HighInBC/ZeroCool/README.md

# ZeroCool
Zero cool is a Raspberry Pi Zero based portable bitcoin wallet printer.

This project is not ready for public consumption at this point.

The name of the project is a reference to one of the best/worst hacker movies ever made **Hackers**(1995).
