HighInBC/ZeroCool/hardware/rev_b/README.md

Warning, this board revision has serious flaws including the barrel jack having the wrong polarity.
DO NOT USE
