HighInBC/ZeroCool/hardware/rev_g/rev_g.pdf

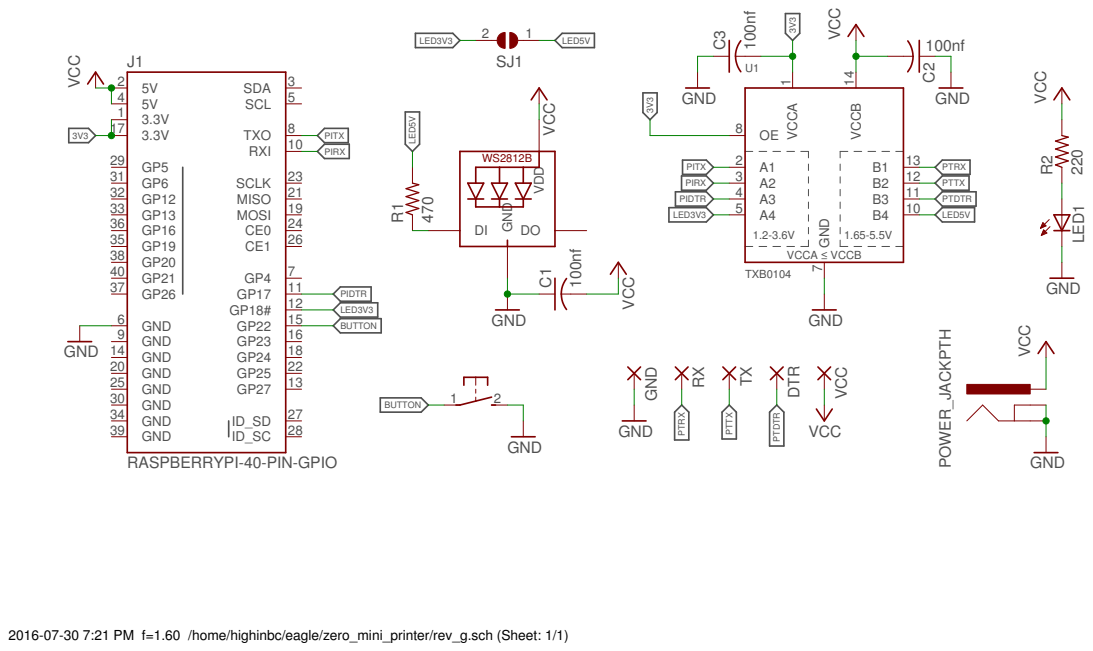
[picture p1: page 1]

2016-07-30 7:21 PM f=1.60 /home/highinbc/eagle/zero_mini_printer/rev_g.sch (Sheet: 1/1)
