HighInBC/ZeroCool/hardware/rev_b/rev_b.pdf

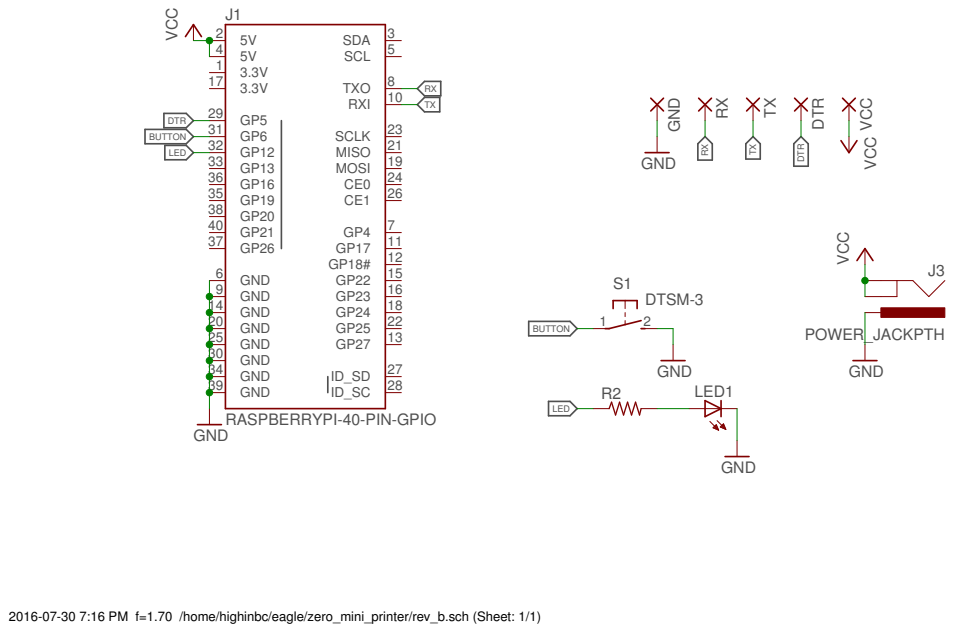
[picture p2: page 1]

2016-07-30 7:16 PM f=1.70 /home/highinbc/eagle/zero_mini_printer/rev_b.sch (Sheet: 1/1)
