HighInBC/ZeroCool/hardware/rev_g/rev_g.brd

## EAGLE design hardware/rev_g/rev_g.brd (2016-07-31)

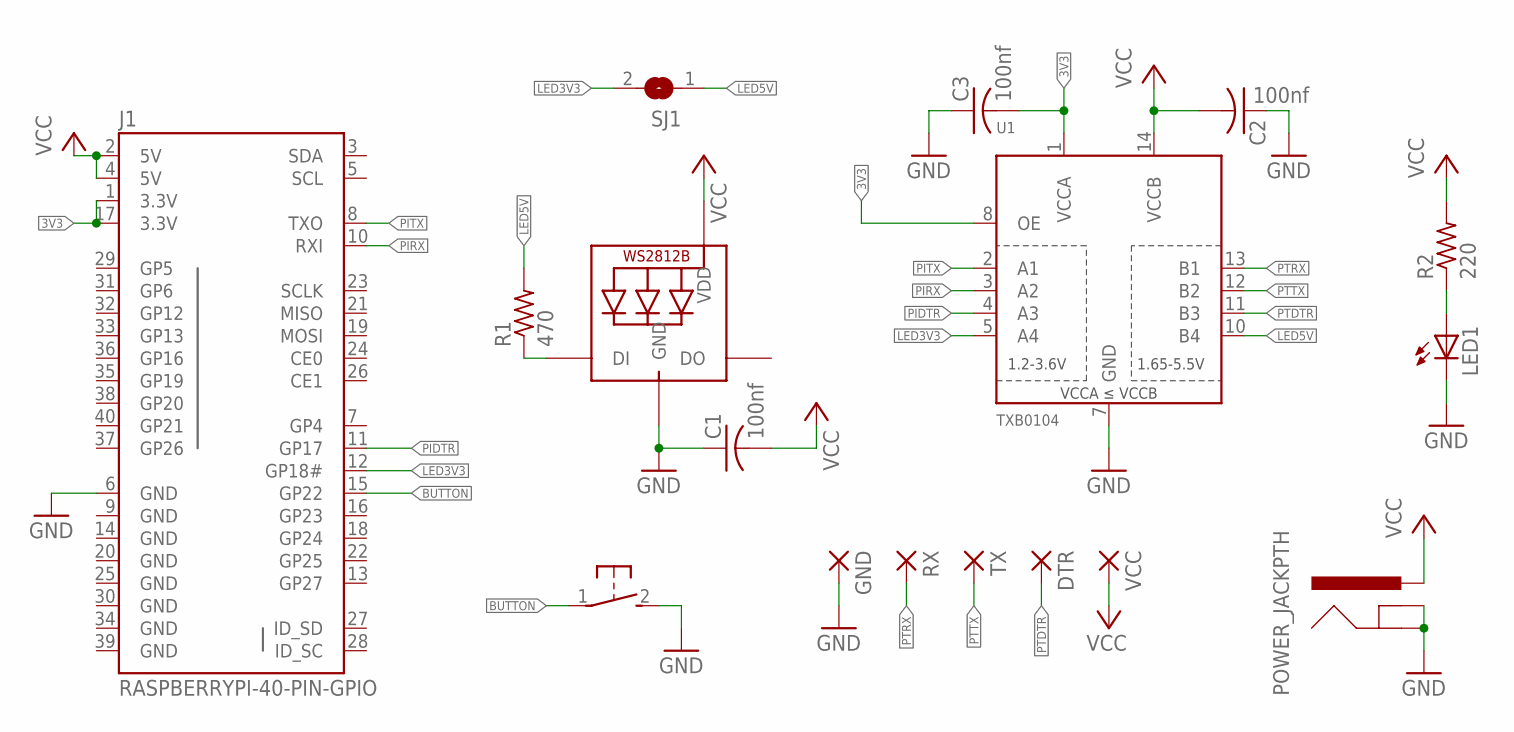
[picture p3: schematic rev_g.sch]

Parts:
C1, C2, C3: 100nf; C0805K
DTR: SMD5; SMD2,54-5,08
GND: SMD5; SMD2,54-5,08
J1: RASPBERRYPI-40-PIN-GPIO; 2X20-SHROUDED
J3: POWER_JACKPTH; POWER_JACK_PTH
LED1: LEDCHIPLED_0805; CHIPLED_0805
LED2: WS2812B5050; WS2812B
R1: 470; M0805
R2: 220; M0805
RX: SMD5; SMD2,54-5,08
S1: DTSM-3
SJ1: SJ
TX: SMD5; SMD2,54-5,08
U1: TXB0104; TSSOP14
VCC: SMD5; SMD2,54-5,08

Connections:
3V3: C3.2, J1.1 (3.3V), J1.17 (3.3V), U1.1 (VCCA), U1.8 (OE)
BUTTON: J1.15 (GP22), S1.1
GND: C1.1, C2.1, C3.1, GND.1, J1.6 (GND), J1.9 (GND), J1.14 (GND), J1.20 (GND), J1.25 (GND), J1.30 (GND), J1.34 (GND), J1.39 (GND), J3.GND, J3.GNDBREAK, LED1.C, LED2.3-GND (GND), S1.2, U1.7 (GND)
LED3V3: J1.12 (GP18#), SJ1.2, U1.5 (A4)
LED5V: R1.2, SJ1.1, U1.10 (B4)
unnamed: LED2.4-DIN (DI), R1.1
unnamed: LED1.A, R2.1
PIDTR: J1.11 (GP17), U1.4 (A3)
PIRX: J1.10 (RXI), U1.3 (A2)
PITX: J1.8 (TXO), U1.2 (A1)
PTDTR: DTR.1, U1.11 (B3)
PTRX: RX.1, U1.13 (B1)
PTTX: TX.1, U1.12 (B2)
VCC: C1.2, C2.2, J1.2 (5V), J1.4 (5V), J3.PWR, LED2.1-VDD (VDD), R2.2, U1.14 (VCCB), VCC.1

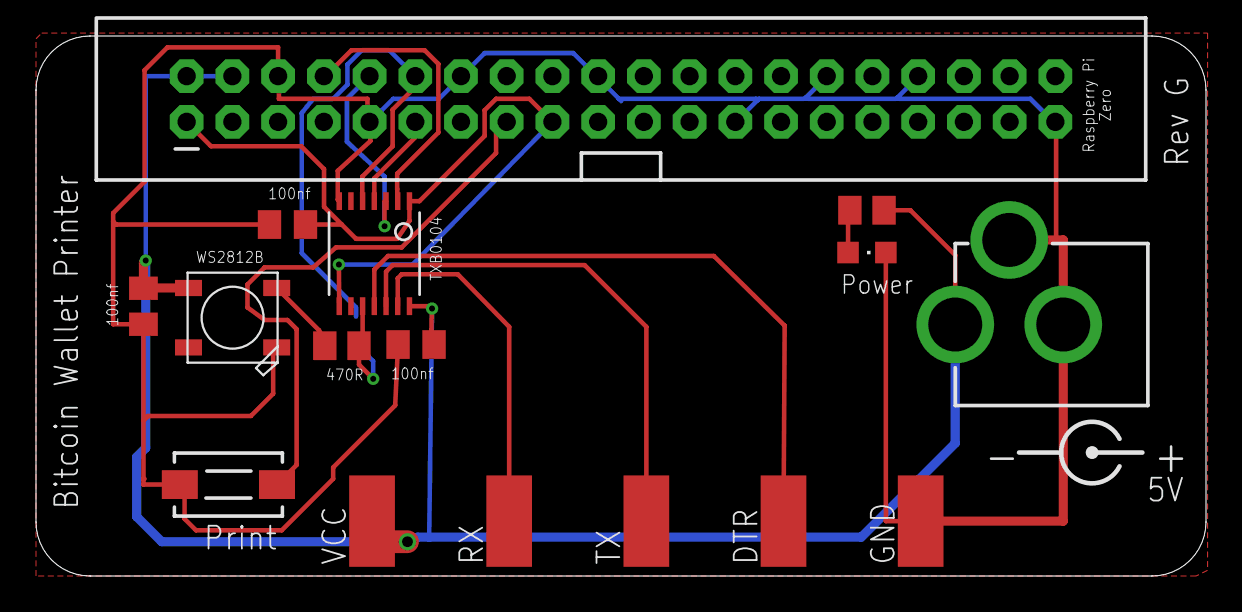
[picture p4: board rev_g.brd from above]

Board: 2 copper layers, 65.0 x 30.0 mm, 17 parts (1 on the bottom side), 14 nets.
