HighInBC/ZeroCool/hardware/rev_b/rev_b.brd

## EAGLE design hardware/rev_b/rev_b.brd (2016-07-31, an earlier design)

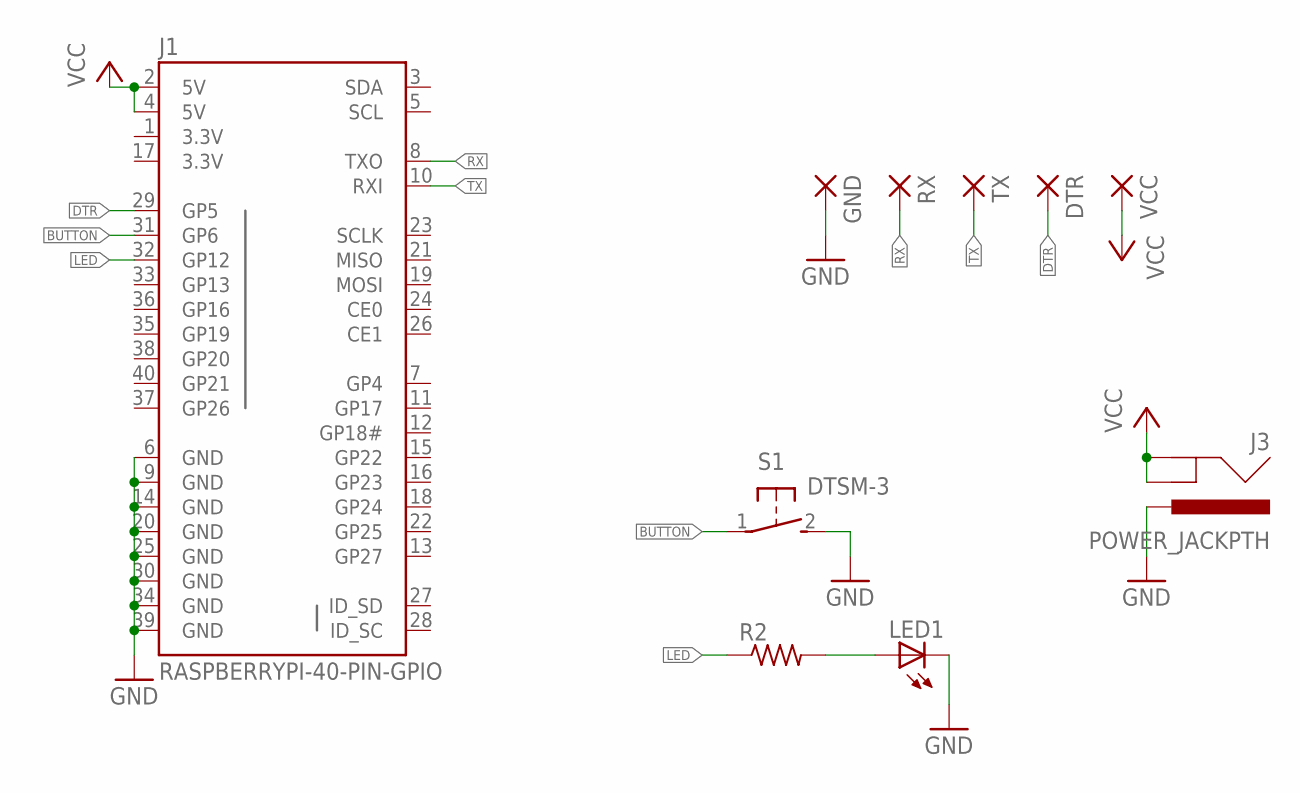
[picture p5: schematic rev_b.sch]

Parts:
DTR: SMD5; SMD2,54-5,08
GND: SMD5; SMD2,54-5,08
J1: RASPBERRYPI-40-PIN-GPIO; 2X20-SHROUDED
J3: POWER_JACKPTH; POWER_JACK_PTH
LED1: LEDSML0805; SML0805
R2: R-US_R0805; R0805
RX: SMD5; SMD2,54-5,08
S1: DTSM-3
TX: SMD5; SMD2,54-5,08
VCC: SMD5; SMD2,54-5,08

Connections:
3.3V: J1.1 (3.3V), J1.17 (3.3V)
BUTTON: J1.31 (GP6), S1.1
DTR: DTR.1, J1.29 (GP5)
GND: GND.1, J1.6 (GND), J1.9 (GND), J1.14 (GND), J1.20 (GND), J1.25 (GND), J1.30 (GND), J1.34 (GND), J1.39 (GND), J3.PWR, LED1.C, S1.2
LED: J1.32 (GP12), R2.1
unnamed: LED1.A, R2.2
RX: J1.8 (TXO), RX.1
TX: J1.10 (RXI), TX.1
VCC: J1.2 (5V), J1.4 (5V), J3.GND, J3.GNDBREAK, VCC.1

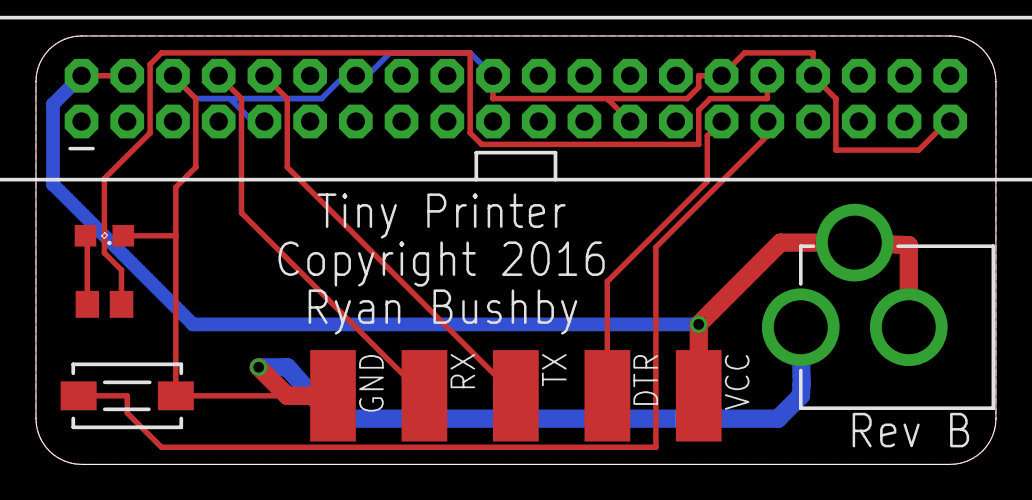
[picture p6: board rev_b.brd from above]

Board: 2 copper layers, 53.3 x 23.8 mm, 10 parts (0 on the bottom side), 9 nets.
