HighInBC/ZeroCool/(threads)

Thread 1 (2016-07-30):

Printer does not respond to Pi

HighInBC, 2016-07-30:
In addition to the printer wanting 5V instead of the 3.3V that the Pi Zero provides the oscilloscope shows ringing on the signal of about 24%.

Going to implement a level converter to 5V, then check signal quality again a find an appropriate resistor if needed.

HighInBC, 2016-07-31:
TXB0104 level converter converted to 5V well enough but ringing was still bad. Added 470ohm resistor and got clean signal. Have not yet tested with actual print.
