HighInBC/ZeroCool/(commit log)

2016-07-31 Early hardware revision
    [rev_b.brd, rev_b.sch]
2016-07-31 more recent version
    [rev_g.brd, rev_g.sch]
