HighInBC/ZeroCool/(notices)

Notices in the files:
hardware/rev_b/rev_b.brd:
Copyright 2016
hardware/rev_g/rev_g.brd:
Copyright Ryan Bushby
parts and their libraries:
SparkFun-Boards: Licensing: Creative Commons ShareAlike 4.0 International - https://creativecommons.org/licenses/by-sa/4.0
